weyer7/caravel-breakout-pico-rev-0.0/Caravel-Breakout-Pico-Rev-0.0.kicad_pcb

## KiCad design Caravel-Breakout-Pico-Rev-0.0.kicad_pcb (2026-09-27)

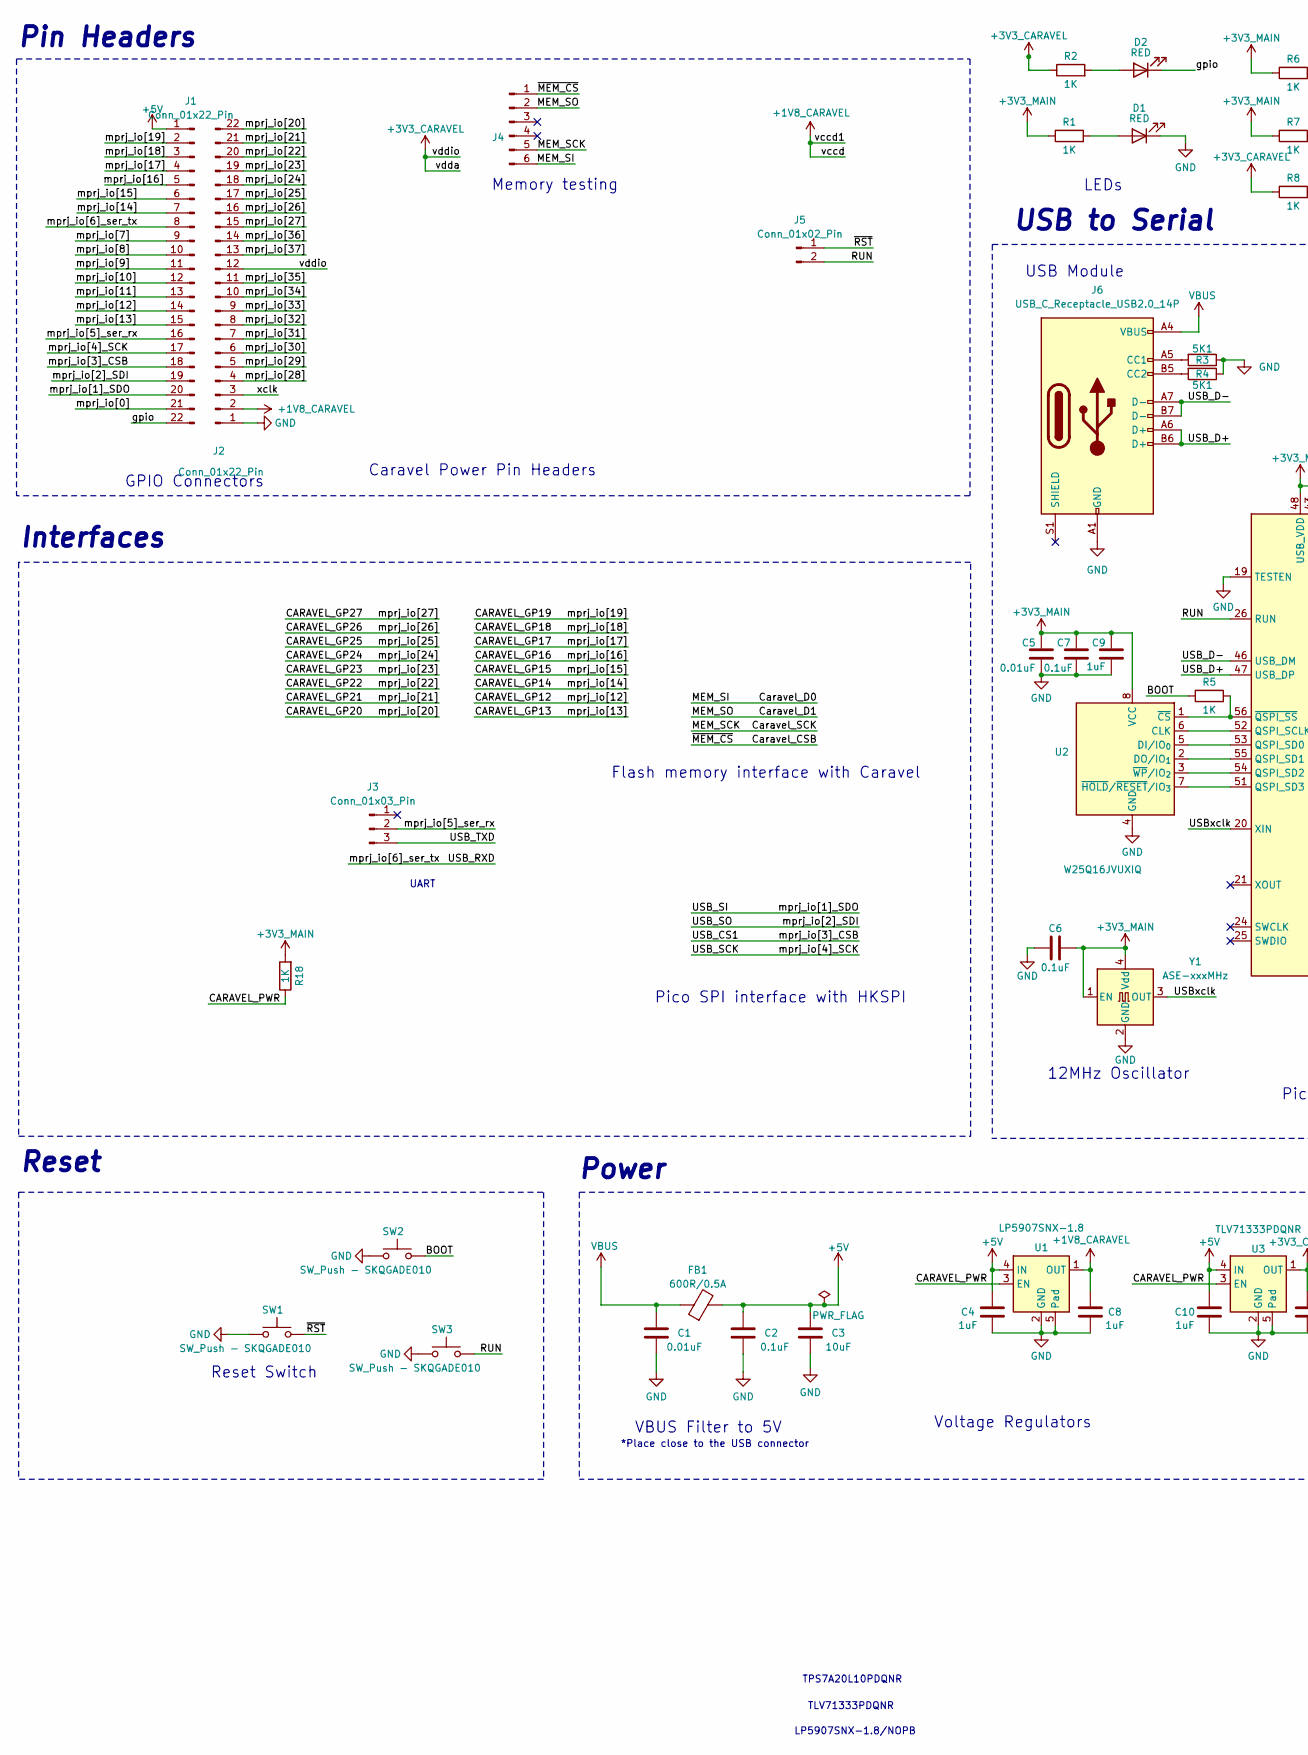
[picture p1: schematic Caravel-Breakout-Pico-Rev-0.0.kicad_sch, Caravel 3.3V Development Board, part in row 1, column 1]

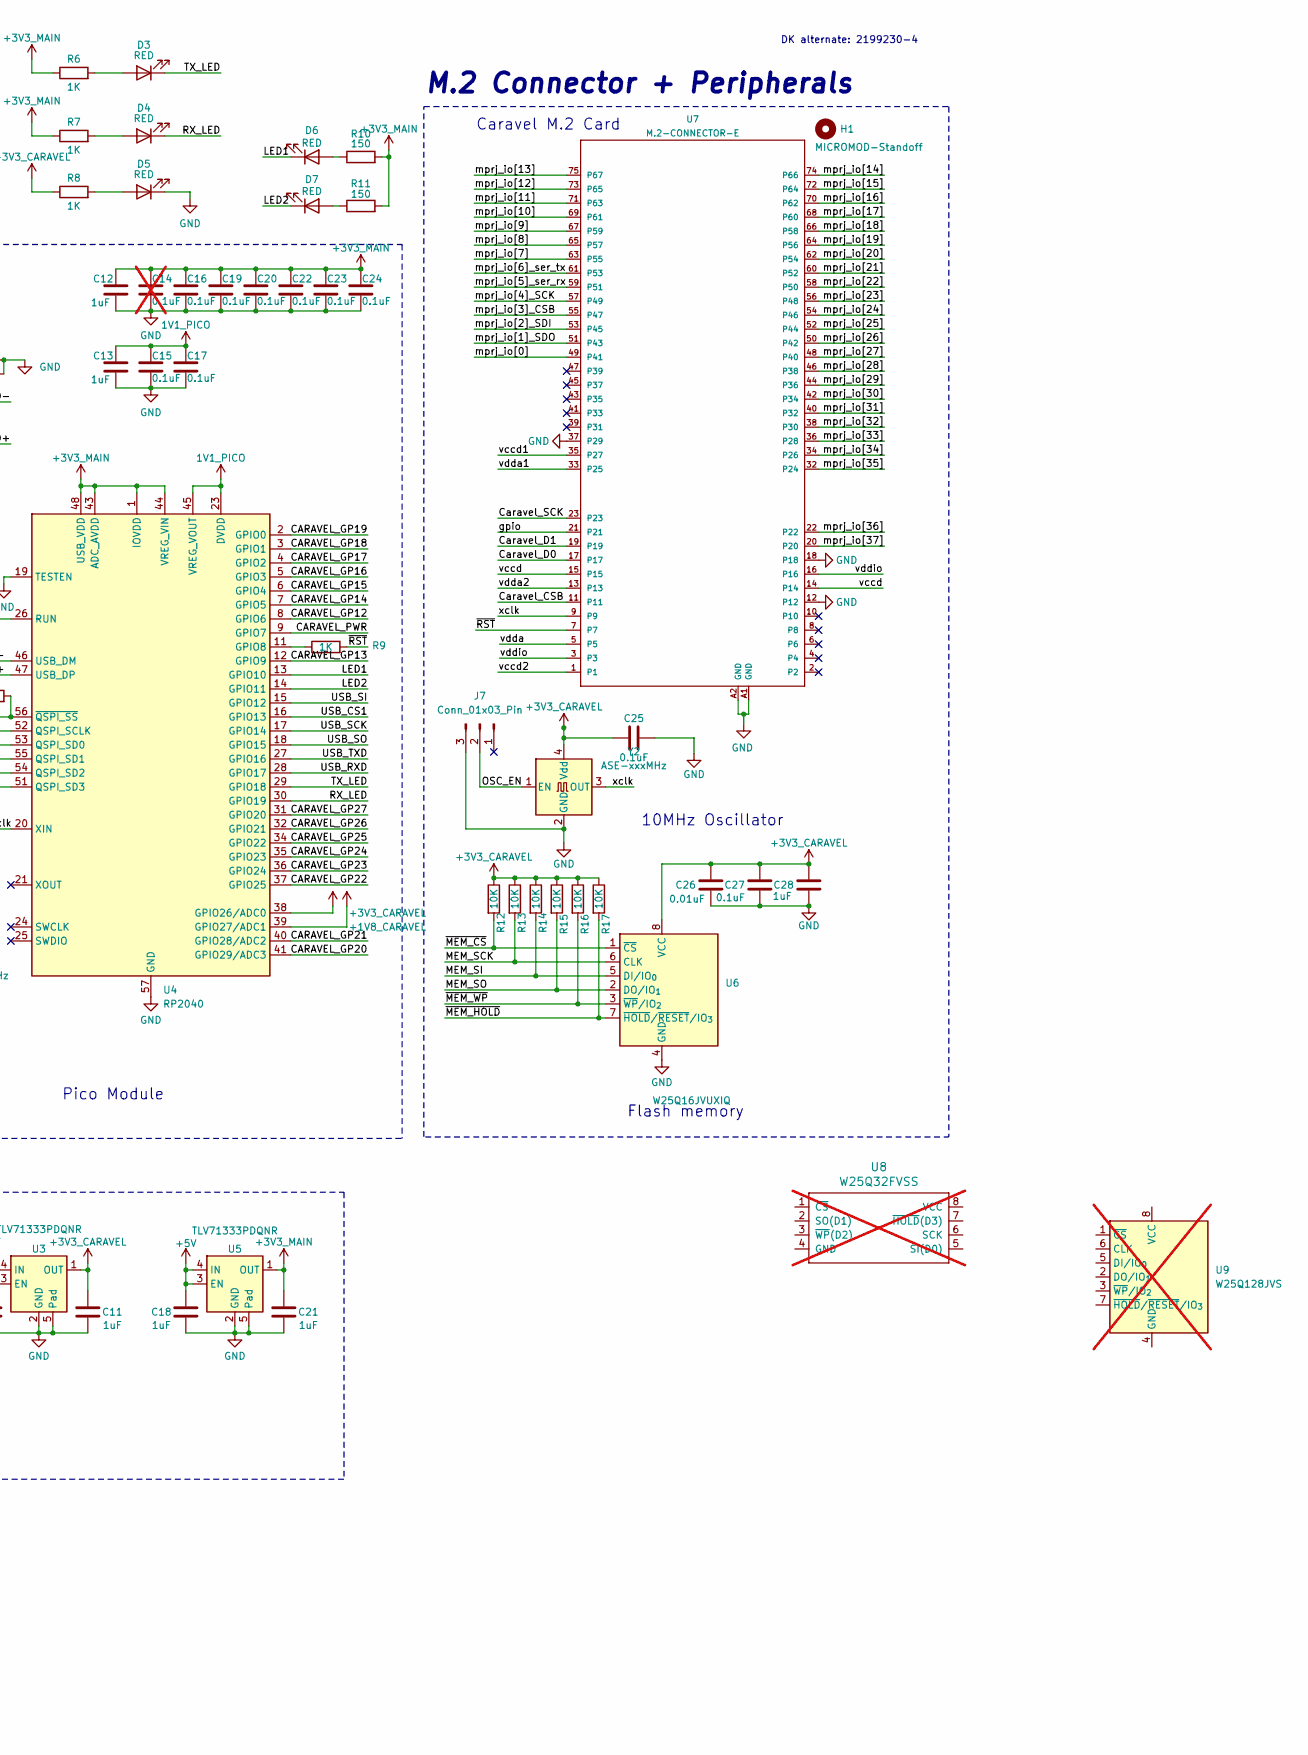
[picture p2: schematic Caravel-Breakout-Pico-Rev-0.0.kicad_sch, Caravel 3.3V Development Board, part in row 1, column 2]

Parts:
C1, C5, C26: 0.01uF; C_0402_1005Metric; Part # C0805C103K5RAC7411
C2, C6, C7, C15, C16, C17, C19, C20, C22, C23, C24, C25, C27: 0.1uF; C_0402_1005Metric; Part # C0805C104K5RAC7411
C3: 10uF; C_0603_1608Metric; Part # CL21B106KAYQNNE
C4, C8, C9, C10, C11, C12, C13, C18, C21, C28: 1uF; C_0402_1005Metric; Part # 885012207103
C14: 0.1uF; C_0402_1005Metric; Part # C0805C104K5RAC7411; not fitted
D1, D2, D3, D4, D5, D6, D7: RED; LED_0603_1608Metric; Part # LTST-C230KRKT
FB1: 600R/0.5A; L_0805_2012Metric; Part # 7427920415
H1: MICROMOD-Standoff; MicroMod-Standoff
J1, J2: Conn_01x22_Pin; PinHeader_1x22_P2.54mm_Vertical
J3, J7: Conn_01x03_Pin; PinHeader_1x03_P1.27mm_Vertical
J4: Conn_01x06_Pin; PinHeader_1x06_P1.27mm_Vertical
J5: Conn_01x02_Pin; PinHeader_1x02_P2.54mm_Vertical
J6: USB_C_Receptacle_USB2.0_14P; USB_C_Receptacle_GCT_USB4105-xx-A_16P_TopMnt_Horizontal
R1, R2, R5, R6, R7, R8, R9, R18: 1K; R_0402_1005Metric; Part # RC0805FR-071KL
R3, R4: 5K1; R_0402_1005Metric
R10, R11: 150; R_0402_1005Metric; Part # RNCP0805FTD150R
R12, R13, R14, R15, R16, R17: 10K; R_0402_1005Metric; Part # RC0805FR-0710KL
SW1, SW2, SW3: SW_Push - SKQGADE010; SW4-SMD-5.2X5.2X1.5MM
U1: LP5907SNX-1.8; Texas_X2SON-4_1x1mm_P0.65mm
U2, U6: W25Q16JVUXIQ; USON-8_UX_2x3x0p6_WIN
U3, U5: TLV71333PDQNR; Texas_X2SON-4_1x1mm_P0.65mm
U4: RP2040; QFN-56-1EP_7x7mm_P0.4mm_EP3.2x3.2mm
U7: M.2-CONNECTOR-E
U8: W25Q32FVSS; SOIC127P790X216-8N; Part # W25Q32JVSSIQ; not fitted
U9: W25Q128JVS; SOIC-8_5.3x5.3mm_P1.27mm; not fitted
Y1, Y2: ASE-xxxMHz; Oscillator_SMD_Abracon_ASE-4Pin_3.2x2.5mm

Connections:
1V1_PICO: C13.1, C15.2, C17.2, U4.23 (DVDD), U4.45 (VREG_VOUT), U4.50 (DVDD)
+1V8_CARAVEL: C8.2, J2.2, U1.1 (OUT), U4.39 (GPIO27/ADC1), U7.14, U7.15, U7.35 (P27)
+3V3_CARAVEL: C11.2, C25.2, C26.2, C27.1, C28.1, J2.12, R2.1, R8.1, R12.1, R13.1, R14.1, R15.1, R16.1, R17.1, U3.1 (OUT), U4.38 (GPIO26/ADC0), U6.8 (VCC), U7.3, U7.5, U7.16, Y2.4 (Vdd)
+3V3_MAIN: C5.2, C6.1, C7.1, C9.1, C12.1, C14.2, C16.2, C19.2, C20.2, C21.2, C22.2, C23.2, C24.2, R1.1, R6.1, R7.1, R10.2, R11.2, R18.2, U2.8 (VCC), U4.1 (IOVDD), U4.10 (IOVDD), U4.22 (IOVDD), U4.33 (IOVDD), U4.42 (IOVDD), U4.43 (ADC_AVDD), U4.44 (VREG_VIN), U4.48 (USB_VDD), U4.49 (IOVDD), U5.1 (OUT), Y1.1 (EN), Y1.4 (Vdd)
+5V: C2.2, C3.2, C4.2, C10.2, C18.2, FB1.2, J1.1, U1.4 (IN), U3.4 (IN), U5.3 (EN), U5.4 (IN)
/BOOT: R5.1, SW2.1
/CARAVEL_GP12: J1.14, U4.8 (GPIO6), U7.73 (P65)
/CARAVEL_GP13: J1.15, U4.12 (GPIO9), U7.75 (P67)
/CARAVEL_GP14: J1.7, U4.7 (GPIO5), U7.74 (P66)
/CARAVEL_GP15: J1.6, U4.6 (GPIO4), U7.72 (P64)
/CARAVEL_GP16: J1.5, U4.5 (GPIO3), U7.70 (P62)
/CARAVEL_GP17: J1.4, U4.4 (GPIO2), U7.68 (P60)
/CARAVEL_GP18: J1.3, U4.3 (GPIO1), U7.66 (P58)
/CARAVEL_GP19: J1.2, U4.2 (GPIO0), U7.64 (P56)
/CARAVEL_GP20: J2.22, U4.41 (GPIO29/ADC3), U7.62 (P54)
/CARAVEL_GP21: J2.21, U4.40 (GPIO28/ADC2), U7.60 (P52)
/CARAVEL_GP22: J2.20, U4.37 (GPIO25), U7.58 (P50)
/CARAVEL_GP23: J2.19, U4.36 (GPIO24), U7.56 (P48)
/CARAVEL_GP24: J2.18, U4.35 (GPIO23), U7.54 (P46)
/CARAVEL_GP25: J2.17, U4.34 (GPIO22), U7.52 (P44)
/CARAVEL_GP26: J2.16, U4.32 (GPIO21), U7.50 (P42)
/CARAVEL_GP27: J2.15, U4.31 (GPIO20), U7.48 (P40)
/CARAVEL_PWR: R18.1, U1.3 (EN), U3.3 (EN), U4.9 (GPIO7)
/Caravel_CSB: J4.1, R12.2, U6.1 (~CS), U7.11
/Caravel_D0: J4.6, R14.2, U6.5 (DI/IO_{0}), U7.17
/Caravel_D1: J4.2, R15.2, U6.2 (DO/IO_{1}), U7.19
/Caravel_SCK: J4.5, R13.2, U6.6 (CLK), U7.23
/LED1: D6.1 (K), U4.13 (GPIO10)
/LED2: D7.1 (K), U4.14 (GPIO11)
/OSC_EN: J7.2, Y2.1 (EN)
/RUN: J5.2, SW3.1, U4.26 (RUN)
/RX_LED: D4.1 (K), U4.30 (GPIO19)
/TX_LED: D3.1 (K), U4.29 (GPIO18)
/USB_CS1: J1.18, U4.16 (GPIO13), U7.55 (P47)
/USB_D+: J6.A6 (D+), J6.B6 (D+), U4.47 (USB_DP)
/USB_D-: J6.A7 (D-), J6.B7 (D-), U4.46 (USB_DM)
/USB_RXD: J1.8, U4.28 (GPIO17), U7.61 (P53)
/USB_SCK: J1.17, U4.17 (GPIO14), U7.57 (P49)
/USB_SI: J1.20, U4.15 (GPIO12), U7.51 (P43)
/USB_SO: J1.19, U4.18 (GPIO15), U7.53 (P45)
/USB_TXD: J3.3, U4.27 (GPIO16)
/USBxclk: U4.20 (XIN), Y1.3 (OUT)
/gpio: D2.1 (K), J1.22, U7.21
/mprj_io[0]: J1.21, U7.49 (P41)
/mprj_io[5]_ser_rx: J1.16, J3.2, U7.59 (P51)
/mprj_io[7]: J1.9, U7.63 (P55)
/mprj_io[8]: J1.10, U7.65 (P57)
/mprj_io[9]: J1.11, U7.67 (P59)
/mprj_io[10]: J1.12, U7.69 (P61)
/mprj_io[11]: J1.13, U7.71 (P63)
/mprj_io[28]: J2.4, U7.46 (P38)
/mprj_io[29]: J2.5, U7.44 (P36)
/mprj_io[30]: J2.6, U7.42 (P34)
/mprj_io[31]: J2.7, U7.40 (P32)
/mprj_io[32]: J2.8, U7.38 (P30)
/mprj_io[33]: J2.9, U7.36 (P28)
/mprj_io[34]: J2.10, U7.34 (P26)
/mprj_io[35]: J2.11, U7.32 (P24)
/mprj_io[36]: J2.14, U7.22
/mprj_io[37]: J2.13, U7.20
/vccd2: U7.1
/vdda1: U7.33 (P25)
/vdda2: U7.13
/xclk: J2.3, U7.9, Y2.3 (OUT)
/~MEM_HOLD: R17.2, U6.7 (~HOLD/~RESET/IO_{3})
/~MEM_WP: R16.2, U6.3 (~WP/IO_{2})
/~RST: J5.1, R9.2, SW1.1, U7.7
GND: C1.2, C2.1, C3.1, C4.1, C5.1, C6.2, C7.2, C8.1, C9.2, C10.1, C11.1, C12.2, C13.2, C14.1, C15.1, C16.1, C17.1, C18.1, C19.1, C20.1, C21.1, C22.1, C23.1, C24.1, C25.1, C26.1, C27.2, C28.2, D1.1 (K), D5.1 (K), J2.1, J6.A1 (GND), J6.A12 (GND), J6.B1 (GND), J6.B12 (GND), J7.3, R3.1, R4.1, SW1.2, SW2.2, SW3.2, U1.2 (GND), U1.5 (Pad), U2.4 (GND), U3.2 (GND), U3.5 (Pad), U4.19 (TESTEN), U4.57 (GND), U5.2 (GND), U5.5 (Pad), U6.4 (GND), U7.12, U7.18, U7.37 (P29), U7.A1 (GND), U7.A2 (GND), Y1.2 (GND), Y2.2 (GND)
unnamed: D1.2 (A), R1.2
unnamed: D2.2 (A), R2.2
unnamed: D3.2 (A), R6.2
unnamed: D4.2 (A), R7.2
unnamed: D5.2 (A), R8.2
unnamed: D6.2 (A), R10.1
unnamed: D7.2 (A), R11.1
unnamed: J6.A5 (CC1), R3.2
unnamed: J6.B5 (CC2), R4.2
unnamed: U2.6 (CLK), U4.52 (QSPI_SCLK)
unnamed: U2.5 (DI/IO_{0}), U4.53 (QSPI_SD0)
unnamed: U2.2 (DO/IO_{1}), U4.55 (QSPI_SD1)
unnamed: R5.2, U2.1 (~CS), U4.56 (~QSPI_SS)
unnamed: U2.7 (~HOLD/~RESET/IO_{3}), U4.51 (QSPI_SD3)
unnamed: U2.3 (~WP/IO_{2}), U4.54 (QSPI_SD2)
unnamed: R9.1, U4.11 (GPIO8)
VBUS: C1.1, FB1.1, J6.A4 (VBUS), J6.A9 (VBUS), J6.B4 (VBUS), J6.B9 (VBUS)

Notes on the sheet:
USB to Serial
USB Module
10MHz Oscillator
*Place close to the USB connector
Flash memory interface with Caravel
TPS7A20L10PDQNR
Caravel Power Pin Headers
GPIO Connectors
LEDs
Flash memory
TLV71333PDQNR
M.2 Connector + Peripherals
12MHz Oscillator
Power
Pin Headers
VBUS Filter to 5V
UART
LP5907SNX-1.8/NOPB
Interfaces
Voltage Regulators
Reset Switch
DK alternate: 2199230-4
Memory testing
Pico SPI interface with HKSPI
Pico Module
Reset
Caravel M.2 Card

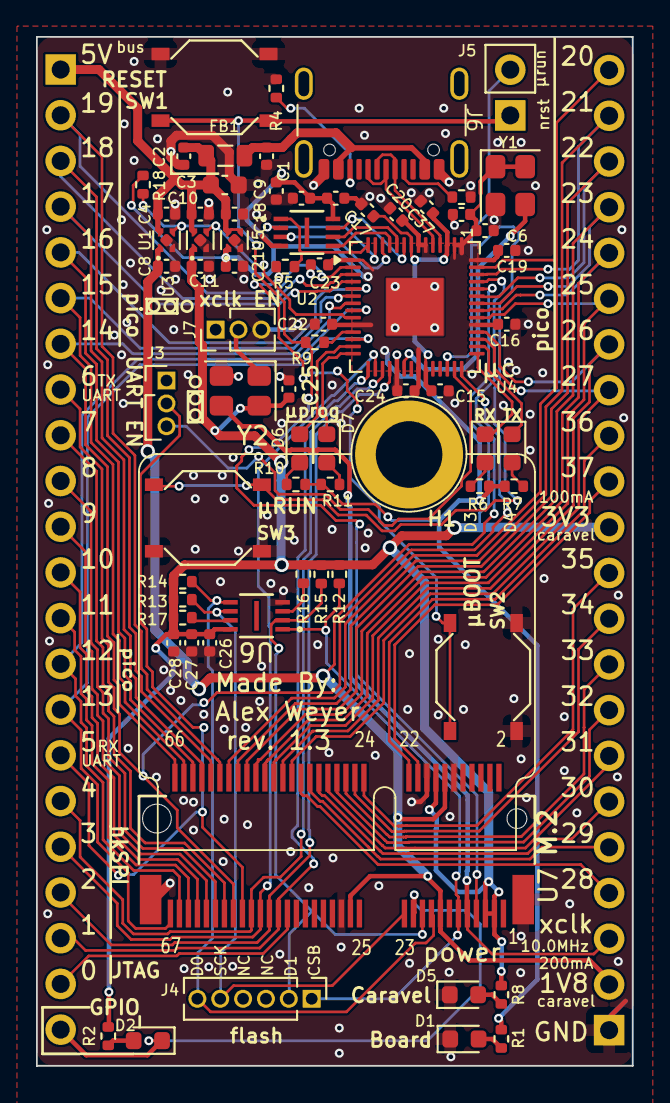
[picture p3: board Caravel-Breakout-Pico-Rev-0.0.kicad_pcb from above]

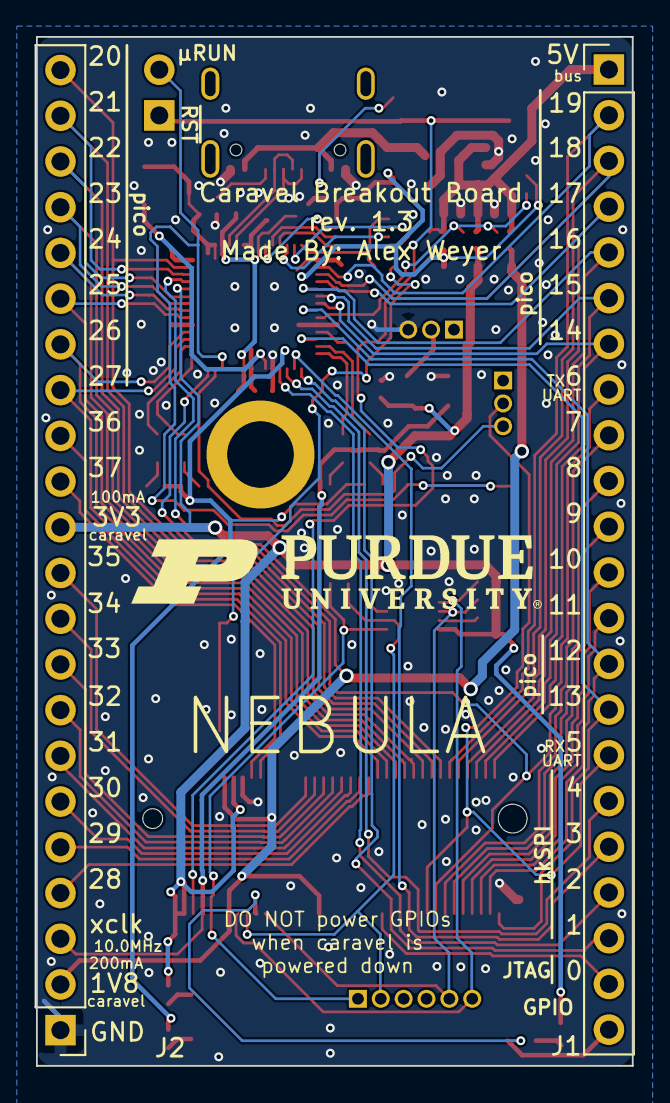
[picture p4: board Caravel-Breakout-Pico-Rev-0.0.kicad_pcb from below]

Board: 4 copper layers, 33.1 x 57.2 mm, 73 parts (2 on the bottom side), 82 nets.
