weyer7/caravel-breakout-pico-rev-0.0/(commit log)

2026-09-27 updated flash chip and added uc button
    [Caravel-Breakout-Pico-Rev-0.0.kicad_pcb, Caravel-Breakout-Pico-Rev-0.0.kicad_sch]
2026-09-27 rev 1.3
    [BOM-Caravel-Breakout-Pico-Rev-0.0.csv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]
